becem0/esp32-giant-chronometer/hardware/bom/bill_of_materials.md

# 📊 Bill of Materials (BOM) & Economic Study

This document details the complete component list, local sourcing prices (Tunisian Market, 2025/2026), and economic comparison against commercial turnkey timing equipment.

---

## 1. Itemized Bill of Materials

| Item Description | Package / Specs | Qty | Unit Price (TND) | Subtotal (TND) |
|---|---|---|---|---|
| **ESP32-WROVER-E Dev Board** | 38-Pin, Dual Core 240MHz, 8MB PSRAM | 1 | 32.00 | 32.00 |
| **74HC595 Shift Register** | DIP-16, High Speed CMOS | 6 | 2.50 | 15.00 |
| **Machined Tulip DIP-16 Sockets** | Elevated Machined Pins | 6 | 1.80 | 10.80 |
| **ULN2803A Darlington Array** | DIP-18, 50V / 500mA Sinking | 6 | 3.20 | 19.20 |
| **Machined Tulip DIP-18 Sockets** | Elevated Machined Pins | 6 | 2.00 | 12.00 |
| **SIM800L GSM Module + SIM** | Quad-band 2G / GPRS | 1 | 45.00 | 45.00 |
| **LM2596 DC-DC Buck Step-Down** | 24V $\to$ 5V/4.1V, 3A Peak | 1 | 12.00 | 12.00 |
| **Low-ESR Electrolytic Capacitor** | $1000\,\mu\text{F}$ / 16V Radial | 2 | 2.50 | 5.00 |
| **Electrolytic Filter Capacitor** | $100\,\mu\text{F}$ / 50V Radial | 2 | 1.50 | 3.00 |
| **Ceramic Decoupling Capacitors** | $100\,\text{nF}$ / 50V (Pack of 20) | 1 | 3.00 | 3.00 |
| **Pull-up/Current Limiting Resistors** | $2.4\,\text{k}\Omega$ / 0.25W (Pack of 10) | 1 | 1.00 | 1.00 |
| **JST-XH 8-Pin Pre-Wired Harnesses** | 2.54mm Pitch (Pack of 10) | 1 | 8.00 | 8.00 |
| **2-Pin Screw Terminals (5.08mm)** | 24V Power In & Logic Out | 2 | 1.20 | 2.40 |
| **Micro-USB Programming Cable** | High-Quality Data Cable | 1 | 8.00 | 8.00 |
| **PCB Artisan Chemical Etching** | Double-sided FR4 (NPTH) | 1 | 80.00 | 80.00 |
| **24V COB LED Strips (High Density)** | SMD Continuous Neon-like, 5m Roll | 2 | 35.00 | 70.00 |
| **S-60-24 SMPS Power Supply** | 230V AC $\to$ 24V DC / 2.5A (60W) | 1 | 55.00 | 55.00 |
| **Forex (PVC) Backplate** | 5mm thickness, $60\times40\,\text{cm}$ | 2 | 18.00 | 36.00 |
| **Opal PMMA Acrylic Diffuser** | 3mm thickness, $60\times40\,\text{cm}$ | 1 | 45.00 | 45.00 |
| **Wiring, Solder, Stand-offs & Hardware** | Assorted Consumables | -- | -- | 137.60 |
| **TOTAL PROJECT INVESTMENT** | | | | **~700.00 TND (~€205)** |

---

## 2. Economic Comparison vs. Commercial Alternatives

| Solution | Typical Price (EUR) | Price (TND) | Customizability | Maintenance |
|---|---|---|---|---|
| **Custom CHRONO_01 (This Project)** | **~€205** | **~700 TND** | **100% Full Open Source Control** | **Modular & Fully Repairable** |
| **Amateur Portable Sports Timer** | €250 – €500 | 850 – 1,700 TND | Locked proprietary firmware | Difficult / Disposable |
| **Turnkey Pro Chronometer (Bodet/Stramatel)** | €900 – €1,500 | 3,060 – 5,100 TND | Vendor App only | High-cost vendor service |
| **Giant 6-Digit Stadium Scoreboard** | €2,500 – €6,000 | 8,500 – 20,400 TND | Fixed features | Proprietary components |
