becem0/esp32-giant-chronometer/docs/stage_chrono_presentation.pdf

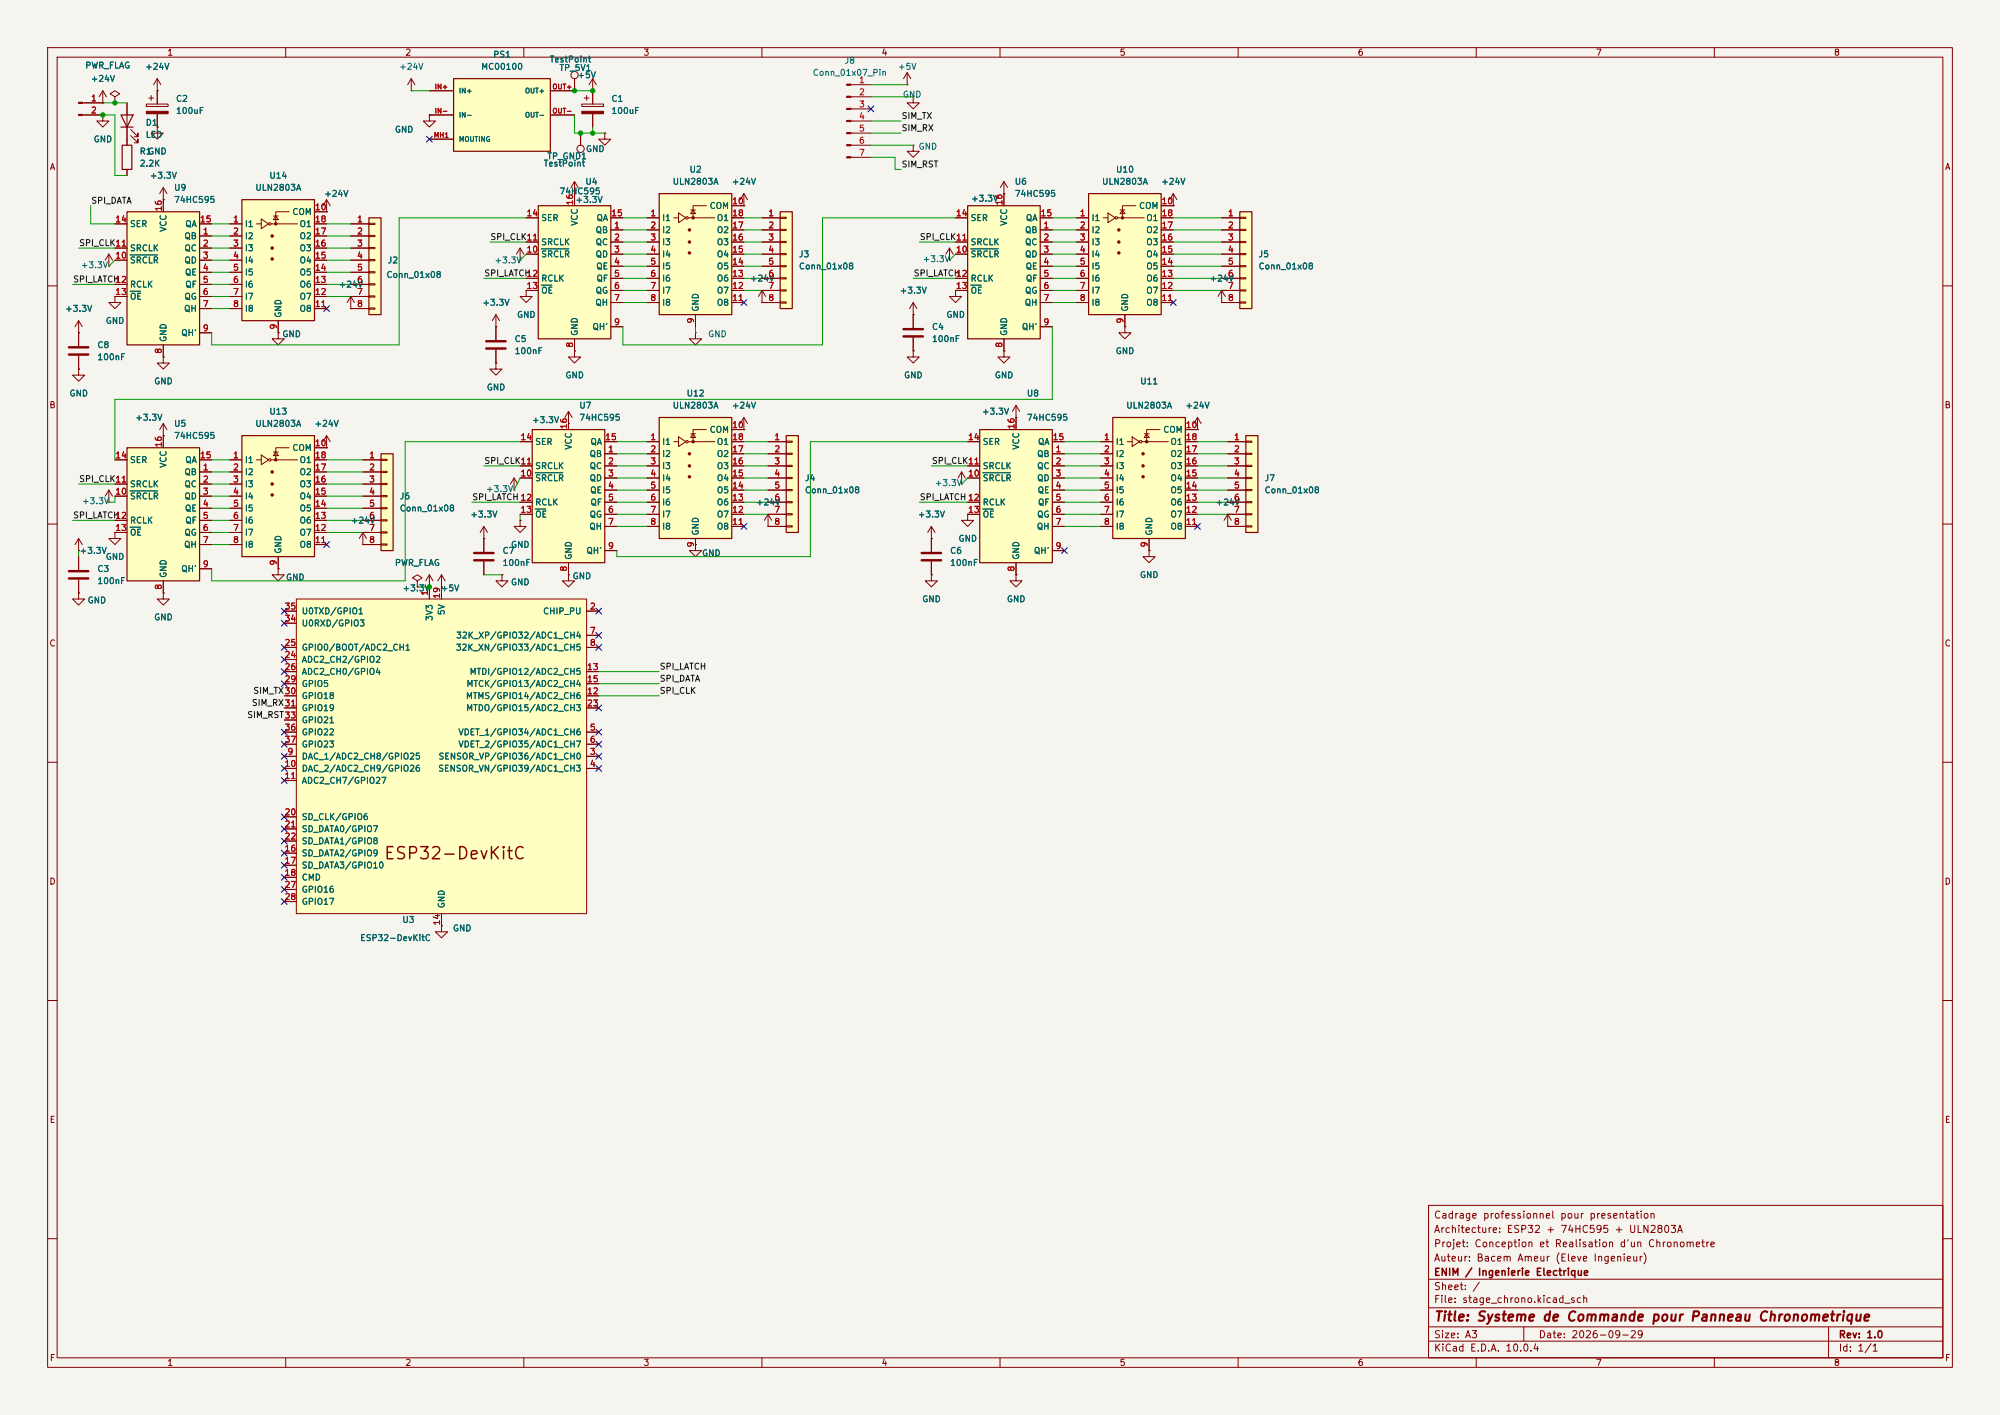
[picture p10: page 1]

I1 1
I2 2 I2 2 GND GND | 2 2

SRCLR 10 SRCLK 11 RCLK 12 OE 13

SRCLR 10 SRCLK 11 RCLK 12 OE 13 | I4 4 | 4 4

I5 5 | 5 5
I6 6 | 6 6
I7 7 | 7 7
I8 8 | 8

9 COM 10 O8 11 O7 12 O6 13 O5 14 O4 15 O3 16 O2 17 O1 18 U13 ULN2803A GND +3.3VGND QB 1 QC 2 QD 3 QE 4 QF 5 QG 6 QH 7 GND

9 COM 10 O8 11 O7 12 O6 13 O5 14 O4 15 O3 16 O2 17 O1 18 U12 ULN2803A GND +3.3V QB 1 QC 2 QD 3 QE 4 QF 5 QG 6 QH 7 GND

ESP32-DevKitC GND 14 5V 19 3V3

SRCLR 10 SRCLK 11 RCLK 12 OE 13 | I5 5 | 5 5

Cadrage professionnel pour presentation
Architecture: ESP32 + 74HC595 + ULN2803A
Projet: Conception et Realisation d'un Chronometre
Auteur: Bacem Ameur (Eleve Ingenieur)
ENIM / Ingenierie Electrique
Sheet: /
File: stage_chrono.kicad_sch
Title: Systeme de Commande pour Panneau Chronometrique

Size: A3 | Rev: 1.0
KiCad E.D.A. 10.0.4 | Id: 1/1 | F Date: 2026-09-29
