becem0/esp32-giant-chronometer/hardware/kicad/stage_chrono.kicad_pcb

## KiCad design hardware/kicad/stage_chrono.kicad_pcb (2026-10-02)

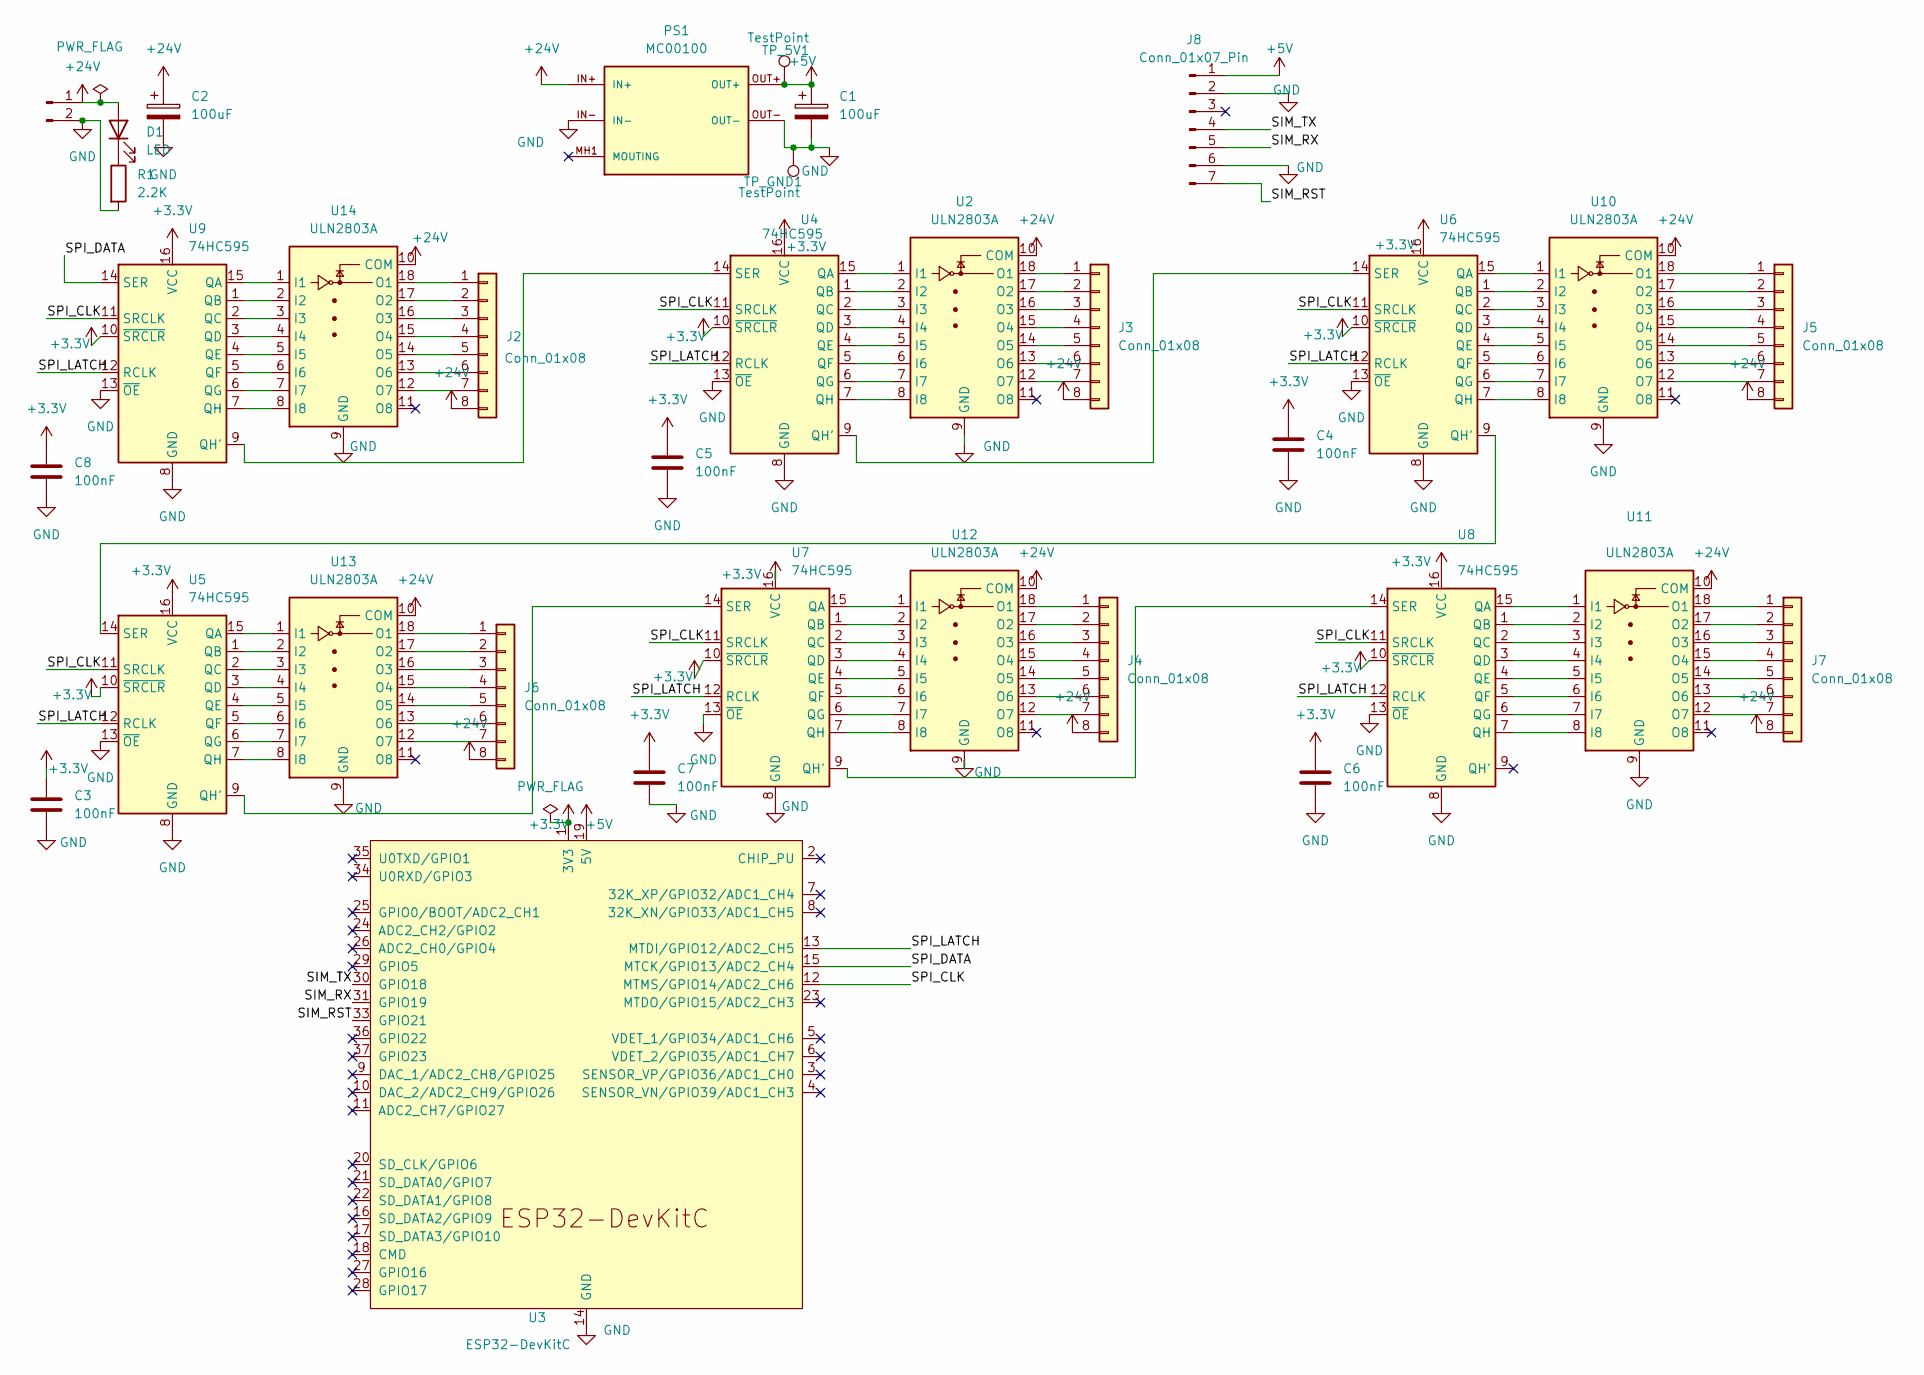
[picture p11: schematic stage_chrono.kicad_sch, Systeme de Commande pour Panneau Chronometrique]

Parts:
C1, C2: 100uF; CP_Radial_D8.0mm_P3.50mm
C3, C4, C5, C6, C7, C8: 100nF; C_Disc_D5.0mm_W2.5mm_P5.00mm
D1: LED; LED_D3.0mm
J1: 24_IN; TerminalBlock_Phoenix_MKDS-1,5-2-5.08_1x02_P5.08mm_Horizont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
J2, J3, J4, J5, J6, J7: Conn_01x08; JST_XH_B8B-XH-A_1x08_P2.50mm_Vertical
J8: Conn_01x07_Pin; PinSocket_1x07_P2.54mm_Vertical
PS1: MC00100; CONV_MC00100; PARTREV NA
R1: 2.2K; R_Axial_DIN0207_L6.3mm_D2.5mm_P7.62mm_Horizontal
TP_5V1: TestPoint; TestPoint_Pad_D1.5mm
TP_GND1: TestPoint; TestPoint_Pad_D1.5mm
U2, U10, U11, U12, U13, U14: ULN2803A; DIP-18_W7.62mm
U3: ESP32-DevKitC
U4, U5, U6, U7, U8, U9: 74HC595; DIP-16_W7.62mm

Connections:
+3.3V: C3.1, C4.1, C5.1, C6.1, C7.1, C8.1, U3.1 (3V3), U4.10 (~SRCLR), U4.16 (VCC), U5.10 (~SRCLR), U5.16 (VCC), U6.10 (~SRCLR), U6.16 (VCC), U7.10 (~SRCLR), U7.16 (VCC), U8.10 (~SRCLR), U8.16 (VCC), U9.10 (~SRCLR), U9.16 (VCC)
+5V: C1.1, J8.1, PS1.OUT+, TP_5V1.1 (1_1), U3.19 (5V)
+24V: C2.1, D1.2 (A), J1.1, J2.8, J3.8, J4.8, J5.8, J6.8, J7.8, PS1.IN+, U2.10 (COM), U10.10 (COM), U11.10 (COM), U12.10 (COM), U13.10 (COM), U14.10 (COM)
/SIM_RST: J8.7, U3.33 (GPIO21)
/SIM_RX: J8.5, U3.31 (GPIO19)
/SIM_TX: J8.4, U3.30 (GPIO18)
/SPI_CLK: U3.12 (MTMS/GPIO14/ADC2_CH6), U4.11 (SRCLK), U5.11 (SRCLK), U6.11 (SRCLK), U7.11 (SRCLK), U8.11 (SRCLK), U9.11 (SRCLK)
/SPI_DATA: U3.15 (MTCK/GPIO13/ADC2_CH4), U9.14 (SER)
/SPI_LATCH: U3.13 (MTDI/GPIO12/ADC2_CH5), U4.12 (RCLK), U5.12 (RCLK), U6.12 (RCLK), U7.12 (RCLK), U8.12 (RCLK), U9.12 (RCLK)
GND: C1.2, C2.2, C3.2, C4.2, C5.2, C6.2, C7.2, C8.2, J1.2, J8.2, J8.6, PS1.IN-, PS1.OUT-, R1.2, TP_GND1.1 (1_1), U2.9 (GND), U3.14 (GND), U3.32 (GND), U3.38 (GND), U4.8 (GND), U4.13 (~OE), U5.8 (GND), U5.13 (~OE), U6.8 (GND), U6.13 (~OE), U7.8 (GND), U7.13 (~OE), U8.8 (GND), U8.13 (~OE), U9.8 (GND), U9.13 (~OE), U10.9 (GND), U11.9 (GND), U12.9 (GND), U13.9 (GND), U14.9 (GND)
unnamed: D1.1 (K), R1.1
unnamed: J2.1, U14.18 (O1)
unnamed: J2.2, U14.17 (O2)
unnamed: J2.3, U14.16 (O3)
unnamed: J2.4, U14.15 (O4)
unnamed: J2.5, U14.14 (O5)
unnamed: J2.6, U14.13 (O6)
unnamed: J2.7, U14.12 (O7)
unnamed: J3.1, U2.18 (O1)
unnamed: J3.2, U2.17 (O2)
unnamed: J3.3, U2.16 (O3)
unnamed: J3.4, U2.15 (O4)
unnamed: J3.5, U2.14 (O5)
unnamed: J3.6, U2.13 (O6)
unnamed: J3.7, U2.12 (O7)
unnamed: J4.1, U12.18 (O1)
unnamed: J4.2, U12.17 (O2)
unnamed: J4.3, U12.16 (O3)
unnamed: J4.4, U12.15 (O4)
unnamed: J4.5, U12.14 (O5)
unnamed: J4.6, U12.13 (O6)
unnamed: J4.7, U12.12 (O7)
unnamed: J5.1, U10.18 (O1)
unnamed: J5.2, U10.17 (O2)
unnamed: J5.3, U10.16 (O3)
unnamed: J5.4, U10.15 (O4)
unnamed: J5.5, U10.14 (O5)
unnamed: J5.6, U10.13 (O6)
unnamed: J5.7, U10.12 (O7)
unnamed: J6.1, U13.18 (O1)
unnamed: J6.2, U13.17 (O2)
unnamed: J6.3, U13.16 (O3)
unnamed: J6.4, U13.15 (O4)
unnamed: J6.5, U13.14 (O5)
unnamed: J6.6, U13.13 (O6)
unnamed: J6.7, U13.12 (O7)
unnamed: J7.1, U11.18 (O1)
unnamed: J7.2, U11.17 (O2)
unnamed: J7.3, U11.16 (O3)
unnamed: J7.4, U11.15 (O4)
unnamed: J7.5, U11.14 (O5)
unnamed: J7.6, U11.13 (O6)
unnamed: J7.7, U11.12 (O7)
unnamed: U2.1 (I1), U4.15 (QA)
unnamed: U2.2 (I2), U4.1 (QB)
unnamed: U2.3 (I3), U4.2 (QC)
unnamed: U2.4 (I4), U4.3 (QD)
unnamed: U2.5 (I5), U4.4 (QE)
unnamed: U2.6 (I6), U4.5 (QF)
unnamed: U2.7 (I7), U4.6 (QG)
unnamed: U2.8 (I8), U4.7 (QH)
unnamed: U4.9 (QH'), U6.14 (SER)
unnamed: U4.14 (SER), U9.9 (QH')
unnamed: U5.9 (QH'), U7.14 (SER)
unnamed: U5.14 (SER), U6.9 (QH')
unnamed: U7.9 (QH'), U8.14 (SER)
unnamed: U6.15 (QA), U10.1 (I1)
unnamed: U6.1 (QB), U10.2 (I2)
unnamed: U6.2 (QC), U10.3 (I3)
unnamed: U6.3 (QD), U10.4 (I4)
unnamed: U6.4 (QE), U10.5 (I5)
unnamed: U6.5 (QF), U10.6 (I6)
unnamed: U6.6 (QG), U10.7 (I7)
unnamed: U6.7 (QH), U10.8 (I8)
unnamed: U8.15 (QA), U11.1 (I1)
unnamed: U8.1 (QB), U11.2 (I2)
unnamed: U8.2 (QC), U11.3 (I3)
unnamed: U8.3 (QD), U11.4 (I4)
unnamed: U8.4 (QE), U11.5 (I5)
unnamed: U8.5 (QF), U11.6 (I6)
unnamed: U8.6 (QG), U11.7 (I7)
unnamed: U8.7 (QH), U11.8 (I8)
unnamed: U7.15 (QA), U12.1 (I1)
unnamed: U7.1 (QB), U12.2 (I2)
unnamed: U7.2 (QC), U12.3 (I3)
unnamed: U7.3 (QD), U12.4 (I4)
unnamed: U7.4 (QE), U12.5 (I5)
unnamed: U7.5 (QF), U12.6 (I6)
unnamed: U7.6 (QG), U12.7 (I7)
unnamed: U7.7 (QH), U12.8 (I8)
unnamed: U5.15 (QA), U13.1 (I1)
unnamed: U5.1 (QB), U13.2 (I2)
unnamed: U5.2 (QC), U13.3 (I3)
unnamed: U5.3 (QD), U13.4 (I4)
unnamed: U5.4 (QE), U13.5 (I5)
unnamed: U5.5 (QF), U13.6 (I6)
unnamed: U5.6 (QG), U13.7 (I7)
unnamed: U5.7 (QH), U13.8 (I8)
unnamed: U9.15 (QA), U14.1 (I1)
unnamed: U9.1 (QB), U14.2 (I2)
unnamed: U9.2 (QC), U14.3 (I3)
unnamed: U9.3 (QD), U14.4 (I4)
unnamed: U9.4 (QE), U14.5 (I5)
unnamed: U9.5 (QF), U14.6 (I6)
unnamed: U9.6 (QG), U14.7 (I7)
unnamed: U9.7 (QH), U14.8 (I8)

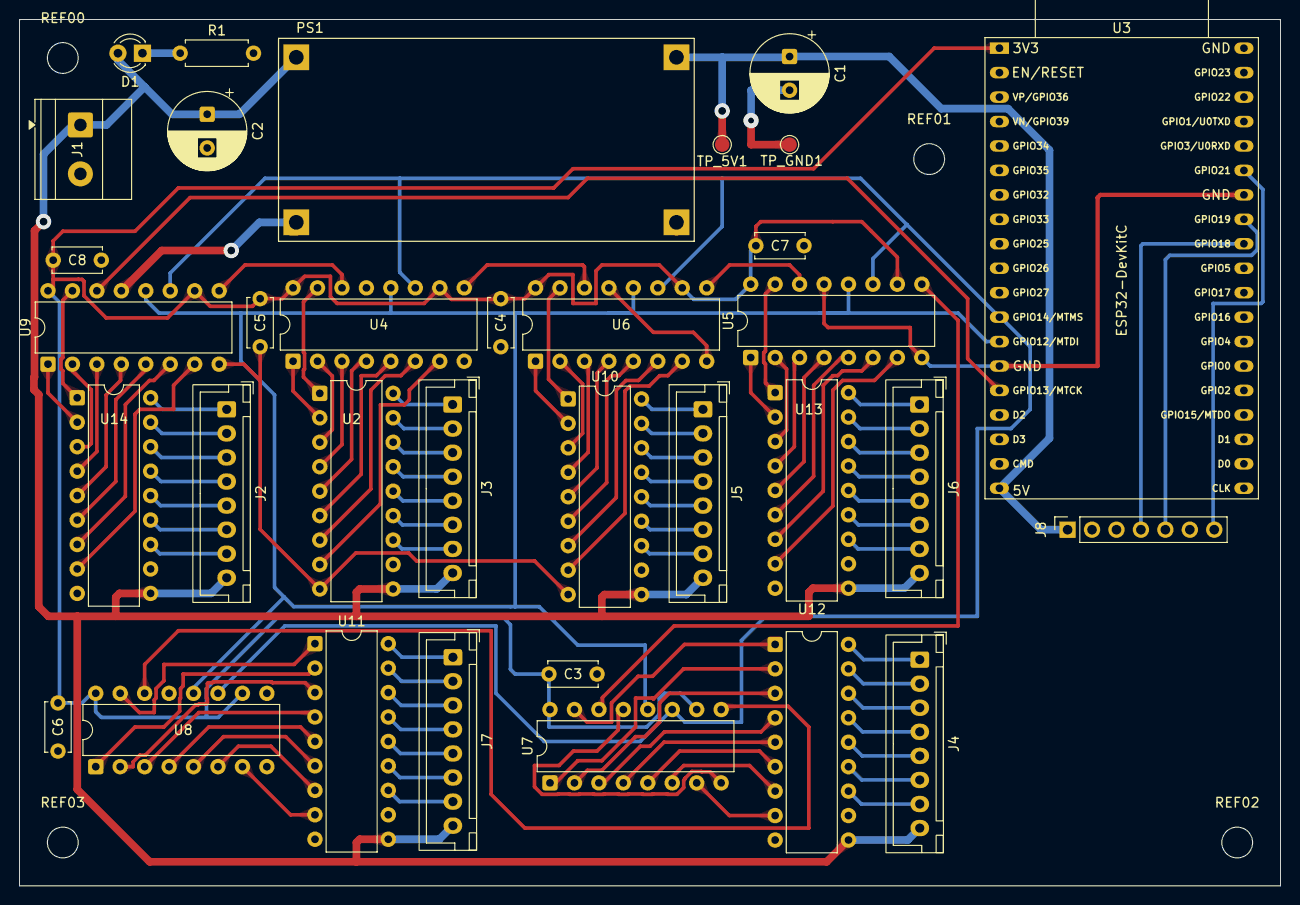
[picture p12: board stage_chrono.kicad_pcb from above]

Board: 2 copper layers, 131.0 x 90.0 mm, 38 parts (0 on the bottom side), 106 nets.

Other parts of the board:
REF00, REF01, REF02, REF03: MountingHole_3.2mm_M3
